TLV1335/IoT-Based-Environmental-Monitorin/docs/images/sensor_node_schematic.png

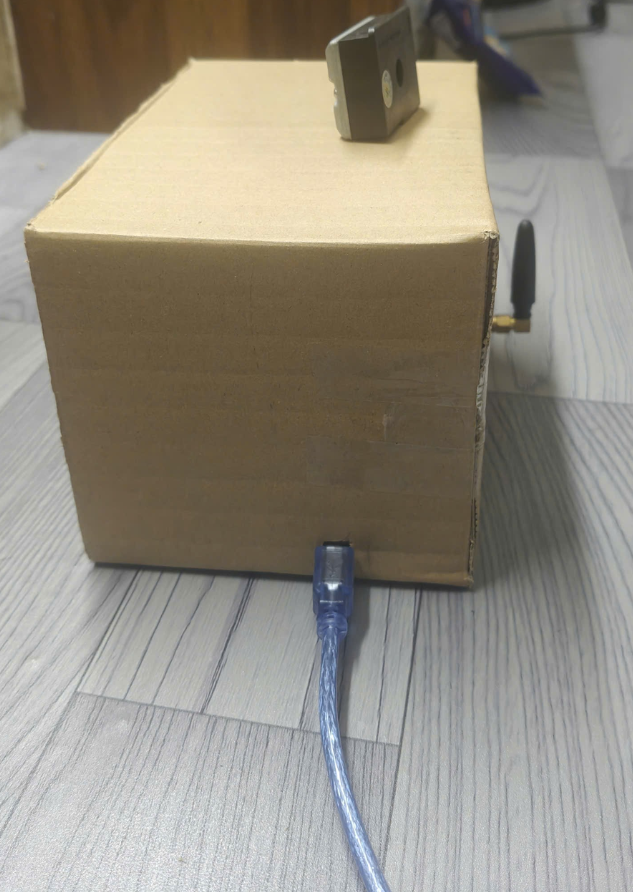
docs/images/sensor_node_schematic.png
